nseidle/Large_Simon_Says/Hardware/Large Simon Says.brd

## EAGLE design Hardware/Large Simon Says.brd (2013-06-10)

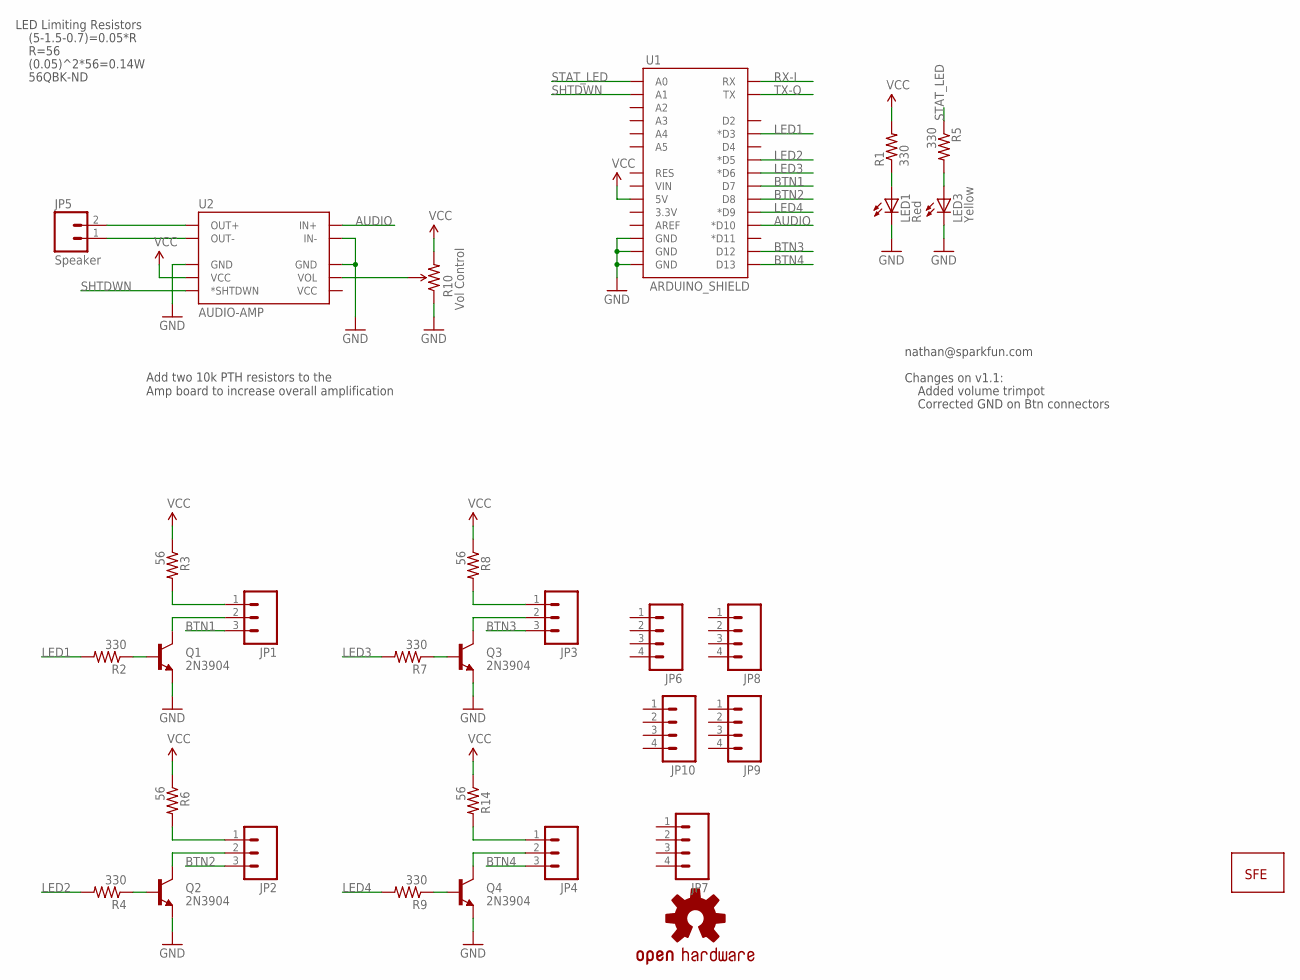
[picture p1: schematic Large Simon Says.sch]

Parts:
JP1, JP2, JP3, JP4: M03JST-PTH-VERT; JST-3-PTH-VERT
JP5: Speaker; JST-2-PTH
JP6, JP7, JP8, JP9, JP10: M04JST-PTH; JST-4-PTH
LED1: Red; LED5MM
LED3: Yellow; LED5MM
Q1, Q2, Q3, Q4: 2N3904; TO-92
R1, R2, R4, R5, R7, R9: 330; AXIAL-0.3
R3, R6, R8, R14: 56; AXIAL-0.3
R10: Vol Control; 3386U
U1: ARDUINO_SHIELD; DUEMILANOVE_SHIELD_NOHOLES
U2: AUDIO-AMP; AUDIO-AMP-MONO
U$1: LOGO-SFENEW; SFE-NEW-WEBLOGO
U$3: OSHW-LOGOS; OSHW-LOGO-S

Connections:
AUDIO: U1.D10 (*D10), U2.IN+
BTN1: JP1.3, U1.D7
BTN2: JP2.3, U1.D8
BTN3: JP3.3, U1.D12
BTN4: JP4.3, U1.D13
GND: LED1.K (C), LED3.K (C), Q1.1 (E), Q2.1 (E), Q3.1 (E), Q4.1 (E), R10.1 (CCW), U1.GND@0 (GND), U1.GND@1 (GND), U1.GND@2 (GND), U2.IN-, U2.PWR- (GND), U2.VOL- (GND)
LED1: R2.P$2 (2), U1.D3 (*D3)
LED2: R4.P$2 (2), U1.D5 (*D5)
LED3: R7.P$2 (2), U1.D6 (*D6)
LED4: R9.P$2 (2), U1.D9 (*D9)
unnamed: LED1.A, R1.P$1 (1)
unnamed: Q1.2 (B), R2.P$1 (1)
unnamed: JP1.2, Q1.3 (C)
unnamed: LED3.A, R5.P$2 (2)
unnamed: JP1.1, R3.P$2 (2)
unnamed: JP2.2, Q2.3 (C)
unnamed: JP4.2, Q4.3 (C)
unnamed: JP5.2, U2.OUT+
unnamed: Q2.2 (B), R4.P$1 (1)
unnamed: JP2.1, R6.P$2 (2)
unnamed: Q3.2 (B), R7.P$1 (1)
unnamed: Q4.2 (B), R9.P$1 (1)
unnamed: JP5.1, U2.OUT-
unnamed: R10.2 (WIPER), U2.VOL
unnamed: JP3.1, R8.P$2 (2)
unnamed: JP4.1, R14.P$2 (2)
unnamed: JP3.2, Q3.3 (C)
RX-I: U1.RX
SHTDWN: U1.A1, U2.S (*SHTDWN)
STAT_LED: R5.P$1 (1), U1.A0
TX-O: U1.TX
VCC: R1.P$2 (2), R3.P$1 (1), R6.P$1 (1), R8.P$1 (1), R10.3 (CW), R14.P$1 (1), U1.5V, U2.PWR+ (VCC)

Notes on the sheet:
Changes on v1.1:
nathan@sparkfun.com
LED Limiting Resistors
(5-1.5-0.7)=0.05*R
R=56
(0.05)^2*56=0.14W
56QBK-ND
Add two 10k PTH resistors to the Amp board to increase overall amplification
Added volume trimpot
Corrected GND on Btn connectors

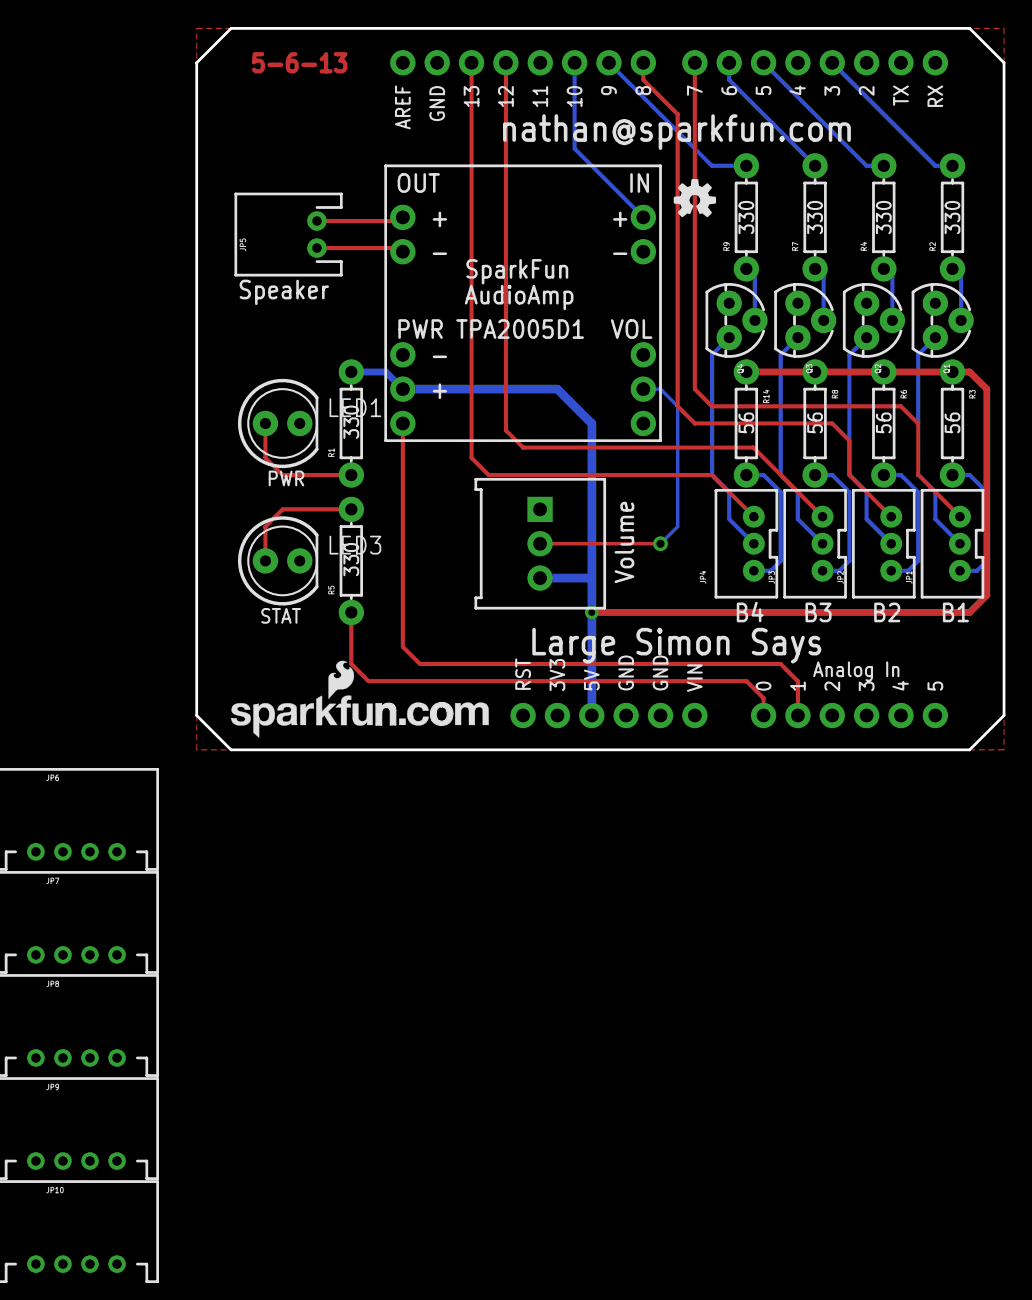
[picture p2: board Large Simon Says.brd from above]

Board: 2 copper layers, 59.7 x 53.3 mm, 31 parts (0 on the bottom side), 30 nets.
