nseidle/Large_Simon_Says/(commit log)

2013-05-06 Updated .ignore and removed extra files.
    [Large Simon Says-v10.GBL, Large Simon Says-v10.GBO, Large Simon Says-v10.GBS, Large Simon Says-v10.GTL, Large Simon Says-v10.GTO, Large Simon Says-v10.GTP, Large Simon Says-v10.GTS]
2013-05-06 Removing version number
    This is considered v1.0.
    [Large Simon Says.brd, Large Simon Says.sch]
2013-06-10 Adding firmware. Small changes to hardware.
    The button connectors are missing a ground connection. Thought I could
    do it with three, but it was a mistake.
    [Large Simon Says.brd, Large Simon Says.sch]
