nseidle/Large_Simon_Says/(notices)

Notices in the files:
parts and their libraries:
SparkFun-Boards: Licensing: CC v3.0 Share-Alike You are welcome to use this library for commercial purposes.
